rentsche/Open-QBox/Documentation/Bill of Materials v1.xlsx

Name | Manufacturer | Supplier | Supplier Part No. | Per Unit Cost | Quantity | Subtotal | Notes
Microcontroller | Adafruit | Digi-Key | 1528-1374-ND | 12.5 | 1
Resistor | Yageo | Digi-Key | 10KEBK-ND | 0.1 | 15
USB-A to USB-micro cable | Assmaan WSW | Digi-Key | AE10342-ND | 4.99 | 1 |  | 2 meter length
8-pin octal connector | ?
4-40 Phillips Pan Hed Bolt | Keystone | Digi-Key | 36-9902-ND | 0.12 | 6 |  | 4-40 x 1/2"
4-40 Hex Nut 1/4" | Keystone | Digi-Key | 36-9600-ND (http://www.digikey.com/product-detail/en/keystone-electronics/9600/36-9600-ND/2746248) | 0.05 | 6
#4 Split Lock Washer | Keystone | Digi-Key | 36-4693-ND (http://www.digikey.com/product-detail/en/keystone-electronics/4693/36-4693-ND/316262) | 0.06 | 6
Microcontroller board screw | ?
Enclosure Lid Screw | ?
